aikatz/sketch-city/docs/index.md

# Sketch City (Team 9)

### The website for Sketch City (Team 9) in ECE 3400, lab section 404. Members: Alex Katz, Christine Ou, Eric Berg, Juan Albrecht, Yazhi Fan

### Website Sections:

#### 1. [Team Contract](contract.md)
#### 2. [Milestones](milestones.md)
#### 3. [Labs](labs.md)
#### 4. [Tutorials](tutorials.md)
#### 5. [Meeting Minutes](minutes.md)
#### 6. [Ethics Assignment](ethics.md)
#### 7. [Final Robot Design](finalrobotdesign.md)
