aikatz/sketch-city/docs/labs.md

## Laboratory Sessions
[LAB 1: Introduction to Microcontrollers](labs/lab1.md)  
[LAB 2: Analog Circuitry and FFTs](labs/lab2.md)  
[LAB 3: FPGA Video Controller and Sound Generation](labs/lab3.md)  
[LAB 4: Radio Communication and Map Drawing](labs/lab4.md)
