aikatz/sketch-city/docs/minutes/11-27-17.md

* Ethics Homework
* Communication information:
  * 16bits total
   * Current position: 5 bits, 2x and 3y
   * Treasure: 2 bits
   * Wall: 4 bits
   * Done: 1 bit
