aikatz/sketch-city/docs/minutes/10-20-17.md

* Lab 4 due next week
* New 3D printed parts
