aikatz/sketch-city/docs/minutes/9-22-17.md

### meeting minutes on 9-22
* Brief meeting on next week’s plan
  * Milestone 2 due on next Wednesday midnight
  * Need to rewire the robot to improve line detection
