aikatz/sketch-city/docs/pictures/lab1/arduinoCodeBlink.png

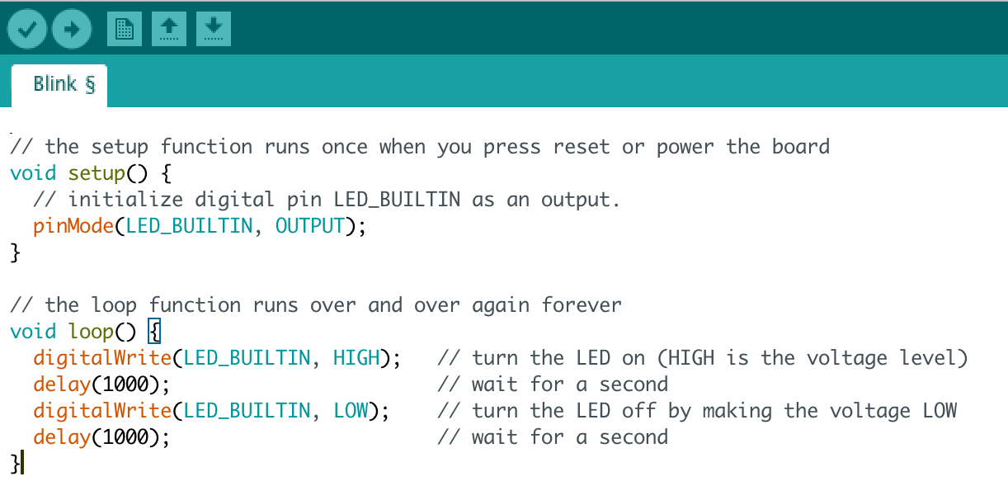
docs/pictures/lab1/arduinoCodeBlink.png
