aikatz/sketch-city/docs/pictures/lab2/20170920_195415.jpg

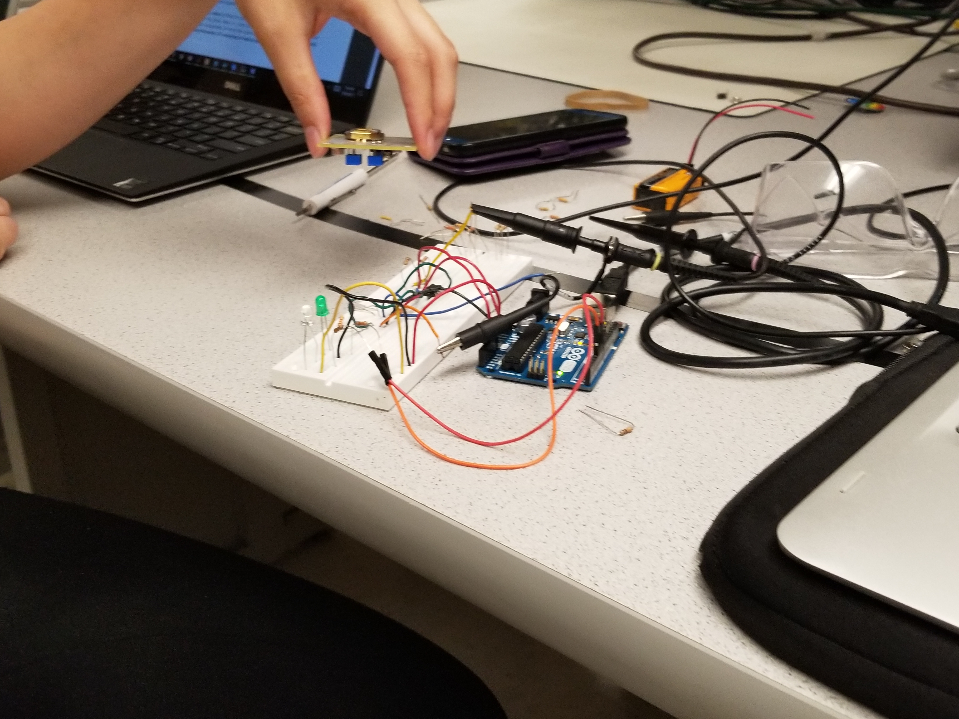
docs/pictures/lab2/20170920_195415.jpg
