aikatz/sketch-city/docs/pictures/lab3/20171018_221256.jpg

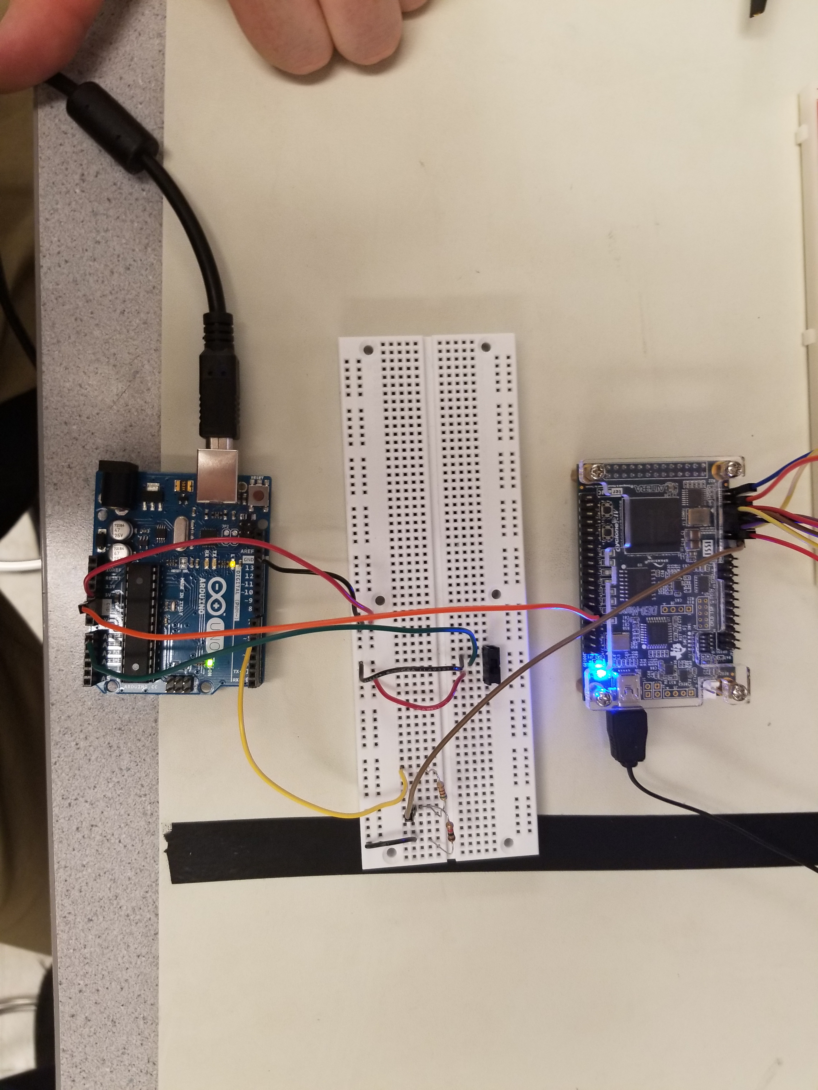
docs/pictures/lab3/20171018_221256.jpg
