aikatz/sketch-city/docs/tutorials.md

[Generating a sine table in Python](tutorials/sinetable.md)
