aikatz/sketch-city/src/dfs/dfs.ino

/*
 *  Reverse a string by using a generic, dynamic stack data structure.
 *
 *  Copyright (C) 2010  Efstathios Chatzikyriakidis (contact@efxa.org)
 *
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
 *  You should have received a copy of the GNU General Public License
 *  along with this program. If not, see <http://www.gnu.org/licenses/>.
 */

// include stack library header.
#include <StackArray.h>
#include <Servo.h>
#include <orientation.h>
#include <state.h>

#include <Wire.h>
#include <VL6180X.h>

#define FULL_POWER_CCW   180
#define MID_POWER_CCW    95
#define LOW_POWER_CCW    93

#define FULL_POWER_CW  0
#define MID_POWER_CW   85
#define LOW_POWER_CW   87

#define SERVO_STOP     90

#define LINE_THRESHOLD 750


VL6180X sensor1;
VL6180X sensor2;
VL6180X sensor3;
int enable1 = 42;
int enable2 = 44;
int enable3 = 46;

// defining a struct to hold information about each intersection
typedef struct {
  int pos_x; // x-coordinate
  int pos_y; // y-coordinate
  int back_x; // back-coordinate x-coordinate
  int back_y; // back-coordinate y-coordinate
  bool visited; // visited state
} intersect;

// Create a matrix with all intersections
intersect inters[5][4];

// Initializing all the intersections of the maze
void initMaze () {
  for (int i = 0; i < 5; i++) {
    for (int j = 0; j < 4; j++) {
      inters[i][j] = {.pos_x = i, .pos_y = j, .back_x = -1, .back_y = -1, .visited = false};
    }
  }
}

// create a stack of characters.
StackArray <intersect> stack;

// Declare two Servo objects - one to control each servo
Servo right_servo;
Servo left_servo; 

// ------------------------ Stores the pin # that is connected to the IR sensor --------------------------------

const int right_sensor_pin = 3;
const int left_sensor_pin = 5;
const int center_sensor_pin = 4;
//const int left_wall_pin = 1;
//const int center_wall_pin = 2;
//const int right_wall_pin = 0;

// ------------------------ Will use this to store the value from the ADC --------------------------------

int right_sensor_value;
int left_sensor_value;
int center_sensor_value;
int left_wall_sensor;
int center_wall_sensor;
int right_wall_sensor;

unsigned long previousMillis = 0;
unsigned long currentMillis = 0;

// ------------------------ Global variables needed for setup --------------------------------

Orientation robotOrient; // Creating an orientation variable to use for the robot's current direction

State goDirection; // Creating a direction variable for the robot to be sent so it can move

int current_pos_x, current_pos_y, go_pos_x, go_pos_y, treasure;

bool visited, wall1, wall2, wall3, wall4; // wall1 -> west; wall2 -> north; wall3 -> east; wall4 -> south

intersect current_intersect, next_intersect; // current and next intersections

int back_pos_x, back_pos_y; // variables to be used in back_pointer

bool walls[3]; // walls from the point of view of the robot

bool actualWalls[4]; // actual walls from the point of view of a 5x4 maze

State current_state, next_state; // symbolizes current and next state 

// -------------------HELPER FUNCTIONS TO HELP SMOOTH THE PROCESS ------------------------------

// Code to update the value of the sensors
void updateSensors() {
  right_sensor_value = analogRead(right_sensor_pin);
  left_sensor_value = analogRead(left_sensor_pin);
  center_sensor_value = analogRead(center_sensor_pin); 
}

// Determining wall presence using surroundings (robot orientation)
void wallRobot(){
  
  // Reading sensors
  left_wall_sensor = sensor3.readRangeContinuousMillimeters(); 
  center_wall_sensor = sensor2.readRangeContinuousMillimeters(); 
  right_wall_sensor = sensor1.readRangeContinuousMillimeters(); 

  // The output of this function is described as left-center-right
  // with reference to the robot
  walls[0] = (left_wall_sensor > 25);
  walls[1] = (center_wall_sensor > 60);
  walls[2] = (right_wall_sensor > 25);
}

// Function that updates the stack with possible paths, so make sure to call it only once!
void updateStack(){
      
  // Pushing possible paths into the stack
  switch(robotOrient){
    case NORTH: 
      if(walls[0] == false) { stack.push(inters[current_pos_x][current_pos_y - 1]); }
      if(walls[2] == false) { stack.push(inters[current_pos_x][current_pos_y + 1]); }
      if(walls[1] == false) { stack.push(inters[current_pos_x - 1][current_pos_y]); }
      break;
    case EAST: 
      if(walls[0] == false) { stack.push(inters[current_pos_x - 1][current_pos_y]); }
      if(walls[2] == false) { stack.push(inters[current_pos_x + 1][current_pos_y]); }
      if(walls[1] == false) { stack.push(inters[current_pos_x][current_pos_y + 1]); }
      break;
    case SOUTH: 
      if(walls[0] == false) { stack.push(inters[current_pos_x][current_pos_y + 1]); }
      if(walls[2] == false) { stack.push(inters[current_pos_x][current_pos_y - 1]); }
      if(walls[1] == false) { stack.push(inters[current_pos_x + 1][current_pos_y]); }
      break;
    case WEST: 
      if(walls[0] == false) { stack.push(inters[current_pos_x + 1][current_pos_y]); }
      if(walls[2] == false) { stack.push(inters[current_pos_x - 1][current_pos_y]); }
      if(walls[1] == false) { stack.push(inters[current_pos_x][current_pos_y - 1]); }
      break;
  }
}

// Determining wall presence using the actual maze as orientation
void wallMaze () {
    
  // Initializing array to all false
  for (int i = 0; i < 4; i++) {
    actualWalls[i] = false;
  }
  
  // The output of this function is described as left-up-right-down 
  if (walls[0] == true) {
    switch(robotOrient) {
      case NORTH: 
        actualWalls[0] = true;
          break;
      case EAST: 
        actualWalls[1] = true;
        break;
      case SOUTH: 
        actualWalls[2] = true;
        break;
      case WEST: 
        actualWalls[3] = true;
        break;
    }
  }
  
  if (walls[1] == true) {
    switch(robotOrient) {
      case WEST:  
        actualWalls[0] = true;
        break;
      case NORTH: 
        actualWalls[1] = true;
        break;
      case EAST: 
        actualWalls[2] = true;
        break;
      case SOUTH: 
        actualWalls[3] = true;
        break;
    }
  }
  
  if (walls[2] == true) {
    switch(robotOrient) {
      case SOUTH: 
        actualWalls[0] = true;
        break;
      case WEST: 
        actualWalls[1] = true;
        break;
      case NORTH: 
        actualWalls[2] = true;
        break;
      case EAST: 
        actualWalls[3] = true;
        break;
     }
  }
}

// Determining direction for the robot to move in reference to the robot
State newDir (int x, int y, int go_x, int go_y) {
  
  State newDirection;
  
  switch (robotOrient) {
    case NORTH:
      if (x > go_x) { newDirection = STRAIGHT; }
      else if (x < go_x) { newDirection = TURN_AROUND; }
      else {
        if (y > go_y) { newDirection = LEFT; }
        else if (y < go_y) { newDirection = RIGHT; }
        else { newDirection = STOP; }
      }
      break;
    case EAST:
      if (x > go_x) { newDirection = LEFT; }
      else if (x < go_x) { newDirection = RIGHT; }
      else {
        if (y > go_y) { newDirection = TURN_AROUND; }
        else if (y < go_y) { newDirection = STRAIGHT; }
        else { newDirection = STOP; }
      }
      break;
    case SOUTH:
      if (x > go_x) { newDirection = TURN_AROUND; }
      else if (x < go_x) { newDirection = STRAIGHT; }
      else {
        if (y > go_y) { newDirection = RIGHT; }
        else if (y < go_y) { newDirection = LEFT; }
        else { newDirection = STOP; }
      }
      break;
    case WEST:
      if (x > go_x) { newDirection = RIGHT; }
      else if (x < go_x) { newDirection = LEFT; }
      else {
        if (y > go_y) { newDirection = STRAIGHT; }
        else if (y < go_y) { newDirection = TURN_AROUND; }
        else { newDirection = STOP; }
      }
      break;
  }
  return newDirection;
}

// Function to determine the new orientation of the robot after a movement
void newOrient () {
    
  switch (goDirection) {
    case LEFT:
      if (robotOrient == NORTH) { robotOrient = WEST; }
      else if (robotOrient == EAST) { robotOrient = NORTH; }
      else if (robotOrient == SOUTH) { robotOrient = EAST; }
      else { robotOrient = SOUTH; }
      break;
    case RIGHT:
      if (robotOrient == NORTH) { robotOrient = EAST; }
      else if (robotOrient == EAST) { robotOrient = SOUTH; }
      else if (robotOrient == SOUTH) { robotOrient = WEST; }
      else { robotOrient = NORTH; }
      break;
    case TURN_AROUND:
      if (robotOrient == NORTH) { robotOrient = SOUTH; }
      else if (robotOrient == EAST) { robotOrient = WEST; }
      else if (robotOrient == SOUTH) { robotOrient = NORTH; }
      else { robotOrient = EAST; }
      break;
    default:
      // keeps current orientation in all the other cases
      break;
  }
}

// Hardware algortihm to move the robot
void movement (State dir) {

  next_state = dir;
  current_state = next_state;
  previousMillis = 0;

  
  while(current_state != STOP) {
    updateSensors(); // updating the sensors
    current_state = next_state; // updating state

//    Serial.print(left_sensor_value);
//    Serial.print("-");
//    Serial.print(center_sensor_value);
//    Serial.print("-");
//    Serial.println(right_sensor_value);
    
    // State Outputs depending on current state and sensor readings
    switch(current_state) {
      
      case STOP:
        left_servo.write(SERVO_STOP);
        right_servo.write(SERVO_STOP);
        break;
        
      case STRAIGHT: 
        if(right_sensor_value > LINE_THRESHOLD && left_sensor_value > LINE_THRESHOLD){
          while(right_sensor_value > LINE_THRESHOLD && left_sensor_value > LINE_THRESHOLD){
            right_servo.write(MID_POWER_CW);
            left_servo.write(MID_POWER_CCW);
            updateSensors();
            // stays going straight
          }
          next_state = INTERSECTION;
        } 
        else if(right_sensor_value > LINE_THRESHOLD) { next_state = SLIGHT_RIGHT; }  
        else if(left_sensor_value > LINE_THRESHOLD) { next_state = SLIGHT_LEFT; }
       
        else {                                                                      
          right_servo.write(MID_POWER_CW);
          left_servo.write(MID_POWER_CCW);
          next_state = STRAIGHT;
        }
      
        break;
        
      case SLIGHT_RIGHT:
        //Serial.println("SLIGHT RIGHT");                                                      
        right_servo.write(LOW_POWER_CW);
        left_servo.write(MID_POWER_CCW);
        
        if(right_sensor_value > LINE_THRESHOLD && left_sensor_value > LINE_THRESHOLD){
          next_state = INTERSECTION;
        }
        else if(right_sensor_value > LINE_THRESHOLD) { next_state = SLIGHT_RIGHT; }
        else { next_state = STRAIGHT; }
        break;
        
      case SLIGHT_LEFT:             
        //Serial.println("SLIGHT LEFT");                                                                                                       
        right_servo.write(MID_POWER_CW);
        left_servo.write(LOW_POWER_CCW);
        
        if(right_sensor_value > LINE_THRESHOLD && left_sensor_value > LINE_THRESHOLD){
          next_state = INTERSECTION;
        }
        else if(left_sensor_value > LINE_THRESHOLD) { next_state = SLIGHT_LEFT; }
        else next_state = STRAIGHT;
        break;
        
      case INTERSECTION:
        //Serial.println("INTERSECT");
        right_servo.write(MID_POWER_CW);
        left_servo.write(MID_POWER_CCW);
        int currentMillis;
        currentMillis = millis();
        while(millis() - currentMillis < 500);
        next_state = STOP;        
        break;
        
      case RIGHT:
        //Serial.println("RIGHT");
        right_servo.write(FULL_POWER_CCW);
        left_servo.write(FULL_POWER_CCW);
  
        if(previousMillis == 0) {
           previousMillis = millis();
        }
        
        currentMillis = millis();
        
        if(currentMillis - previousMillis > 570) next_state = STRAIGHT;
        else next_state = RIGHT;
        break;
        
      case LEFT:
        //Serial.println("LEFT");
        right_servo.write(FULL_POWER_CW);
        left_servo.write(FULL_POWER_CW);
  
        if(previousMillis == 0) {
           previousMillis = millis();
        }
        
        currentMillis = millis();
        
        if(currentMillis - previousMillis > 570) next_state = STRAIGHT;
        else next_state = LEFT;
        break;
  
      case TURN_AROUND:
        //Serial.println("Turn Around");
        right_servo.write(FULL_POWER_CW);
        left_servo.write(FULL_POWER_CW);
        
        if(previousMillis == 0) {
           previousMillis = millis();
        }
        
        currentMillis = millis();
        
        if(currentMillis - previousMillis > 1150) next_state = STRAIGHT;
        else next_state = TURN_AROUND;
        break;
  
      default: // not going to happen since it can only be one of the above
        right_servo.write(SERVO_STOP);
        left_servo.write(SERVO_STOP);
    }
    delay(15);
  }
}

// Function to get every possible path (not a wall) on the stack 
void updateStack_getWalls(){
  wallRobot(); // gets possible paths
  updateStack(); // updates the stack
  wallMaze(); // wall detection in real path
}

// Function to check if the backpointer algorithm can exit the while loop and the robot can proceed
bool notYet(){

  // abs(current_pos_x - go_pos_x) > 1 || abs(current_pos_y - go_pos_y) > 1); // Just in case we determine walls do not need to be checked-off
  
  wallRobot();
  wallMaze(); // getting the walls
  
  if (abs(current_pos_x - go_pos_x) > 1){
    return true;
  }
  else if (current_pos_x - go_pos_x == 1){
    if (current_pos_y == go_pos_y){
      return actualWalls[1];
    }
    else{
      return true;
    }
  }
  else if (current_pos_x - go_pos_x == -1){
    if (current_pos_y == go_pos_y){
      return actualWalls[3];
    }
    else{
      return true;
    }
  }
  else{
    if (abs(current_pos_y - go_pos_y) > 1){
      return true;
    }
    else if (current_pos_y - go_pos_y == 1){
      return actualWalls[0];
    }
    else if (current_pos_y - go_pos_y == -1){
      return actualWalls[2];
    }
    else{
      Serial.print("Check the code because this should never happen");
      return true;
    }
  }
}

void setup() {  
  pinMode(LED_BUILTIN, OUTPUT);

  //TOF wall sensors setup
  pinMode(enable1,OUTPUT);
  pinMode(enable2,OUTPUT);
  pinMode(enable3,OUTPUT);
  Serial.begin(9600);
  Wire.begin();

  digitalWrite(enable1,HIGH);//turn on sensor1
  digitalWrite(enable2,LOW);//turn off sensor2
  digitalWrite(enable2,LOW);//turn off sensor3
  sensor1.init();
  sensor1.configureDefault();
  sensor1.setTimeout(500);
  delay(500);
  sensor1.setAddress(0b1111011);//change I2C address

  digitalWrite(enable2,HIGH); //turn on sensor2
  sensor2.init();
  sensor2.configureDefault();
  sensor2.setTimeout(500);
  delay(500);
  sensor2.setAddress(0b1011011); //change I2C address

  digitalWrite(enable3,HIGH); //turn on sensor3
  sensor3.init();
  sensor3.configureDefault();
  sensor3.setTimeout(500);
  delay(500);

  sensor1.setScaling(1);
  sensor2.setScaling(1);
  sensor3.setScaling(1);

  //set convergence time and integration values for all sensors
  sensor1.writeReg(VL6180X::SYSRANGE__MAX_CONVERGENCE_TIME, 30);
  sensor1.writeReg16Bit(VL6180X::SYSALS__INTEGRATION_PERIOD, 50);
  sensor2.writeReg(VL6180X::SYSRANGE__MAX_CONVERGENCE_TIME, 30);
  sensor2.writeReg16Bit(VL6180X::SYSALS__INTEGRATION_PERIOD, 50);
  sensor3.writeReg(VL6180X::SYSRANGE__MAX_CONVERGENCE_TIME, 30);
  sensor3.writeReg16Bit(VL6180X::SYSALS__INTEGRATION_PERIOD, 50);
  
  //stop continous readings
  sensor1.stopContinuous();
  sensor2.stopContinuous();
  sensor3.stopContinuous();
  delay(300);
  
  //start continous ranging for all sensors
  sensor1.startInterleavedContinuous(100);
  sensor2.startInterleavedContinuous(100);
  sensor3.startInterleavedContinuous(100);

  //WALL SENSORS SETUP END
  
  // Connect right servo to pin 9, left servo to pin 10
  right_servo.attach(10);
  left_servo.attach(9);
  
  right_servo.write(SERVO_STOP);
  left_servo.write(SERVO_STOP);

  // Initializing maze
  initMaze();

  Serial.begin(9600);

  // -------------- DEVELOPING DFS HERE --------------

  // Initial direction
  robotOrient = NORTH;
  
  // Create a while loop that runs until the 60Hz is heard and it lets it end
  // Use an additional input in case it gets stuck

  // Initialize the variables accordingly to the beginning of the maze traversal (lower-left corner)
  current_pos_x = 4;
  current_pos_y = 3;
  
  // Updating initial intersection of the program (lower-right corner)
  inters[current_pos_x][current_pos_y].visited = true;
  
  // Analyzing the possible paths and pushing them into the stack
  wallRobot(); // updating the walls at current intersection
  updateStack(); // updates the stack for available paths
      
  // Update matrix of intersections with the new changes to popped intersection
  inters[current_pos_x][current_pos_y] = current_intersect;
      
  // Send information about the first intersection before starting  
  /*
  // Starting the while loop to interact with the stack
  while(!stack.isEmpty()){

    // Popping the top of the stack
    next_intersect = stack.pop();
    
    // Mark this element visited if it is not visited already. If it is, continue to the next iteration of DFS
    if (!next_intersect.visited) {

      // Update variables of next destination
      go_pos_x = next_intersect.pos_x;
      go_pos_y = next_intersect.pos_y;
      
      // Perform back-pointer algorithm if neccesary
      while (abs(current_pos_x - go_pos_x) > 1 || abs(current_pos_y - go_pos_y) > 1) {
        
        // Back_pointer algorithm goes here
        back_pos_x = current_intersect.back_x;
        back_pos_y = current_intersect.back_y;

        // Moving the robot with new coordinates
        goDirection = newDir(current_pos_x, current_pos_y, back_pos_x, back_pos_y);
        movement(goDirection);

        // Send robot position to the other Arduino (nothing else)

        // Updating current intersection variables
        current_pos_x = back_pos_x;
        current_pos_y = back_pos_y;
        current_intersect = inters[current_pos_x][current_pos_y];  
      }
       
      // Perform movement to intersection specified by the popped element from the stack
      goDirection = newDir(current_pos_x, current_pos_y, go_pos_x, go_pos_y);
      movement(goDirection);

      // Updating all neccesary values for this intersection
      next_intersect.visited = true;
      next_intersect.back_x = current_pos_x;
      next_intersect.back_y = current_pos_y;
      
      // Update variables for next iteration
      current_pos_x = go_pos_x;
      current_pos_y = go_pos_y;
      current_intersect = next_intersect; // updating intersect after first intersection
      newOrient(); // updating orientation
      
      // Update matrix of intersections with the new changes to popped intersection
      inters[current_pos_x][current_pos_y] = current_intersect;
      
      // Analyzing the possible paths and pushing them into the stack
      wallRobot(); // getting the walls
      updateStack(); // updates the stack
 
      // Send information to the other Arduino
      
    }
    
  }*/
  
  //Serial.println("Stack is empty");

  // Play victorious tone here

    movement(STRAIGHT);
    movement(STRAIGHT);
    movement(LEFT);
    movement(RIGHT);
    movement(RIGHT);
    movement(LEFT);
    movement(LEFT);
    movement(STRAIGHT);
    movement(TURN_AROUND);
    movement(STRAIGHT);
}

void loop() {
  // nothing runs here
}
