aikatz/sketch-city/src/Wall_sensors_test/Wall_sensors_test.ino

/*
  Analog Input
 Demonstrates analog input by reading an analog sensor on analog pin 0 and
 turning on and off a light emitting diode(LED)  connected to digital pin 13.
 The amount of time the LED will be on and off depends on
 the value obtained by analogRead().

 The circuit:
 * Potentiometer attached to analog input 0
 * center pin of the potentiometer to the analog pin
 * one side pin (either one) to ground
 * the other side pin to +5V
 * LED anode (long leg) attached to digital output 13
 * LED cathode (short leg) attached to ground

 * Note: because most Arduinos have a built-in LED attached
 to pin 13 on the board, the LED is optional.


 Created by David Cuartielles
 modified 30 Aug 2011
 By Tom Igoe

 This example code is in the public domain.

 http://www.arduino.cc/en/Tutorial/AnalogInput

 */

int left_wall = A3;    // select the input pin for the potentiometer
int forward_wall = A4;      // select the pin for the LED
int right_wall = A5;  // variable to store the value coming from the 

int lw;
int fw;
int rw;

void setup() {
  // declare the ledPin as an OUTPUT:

  Serial.begin(9600);
}


void loop() {
  // read the value from the sensor:
  lw = analogRead(left_wall);
  fw = analogRead(forward_wall);
  rw = analogRead(right_wall);
  Serial.print(lw);
  Serial.print("-");
  Serial.print(fw);
  Serial.print("-");
  Serial.println(rw);

  
  

}
