aikatz/sketch-city/(commit log)

2017-09-06 Arduino Code
2017-11-16 Milestone 3 DFS and wall sensors test
2017-11-20 code for new Laser wall sensors
2017-11-20 code to test a single new laser wall sensor
2017-12-04 working FFT code for second arduino
